craigory1958/SBC6502/README.md

# SBC6502

Single Board Computer for 6502 Processors
