craigory1958/SBC6502/Bus-Timing/SBC6502 MMU Cycle.png

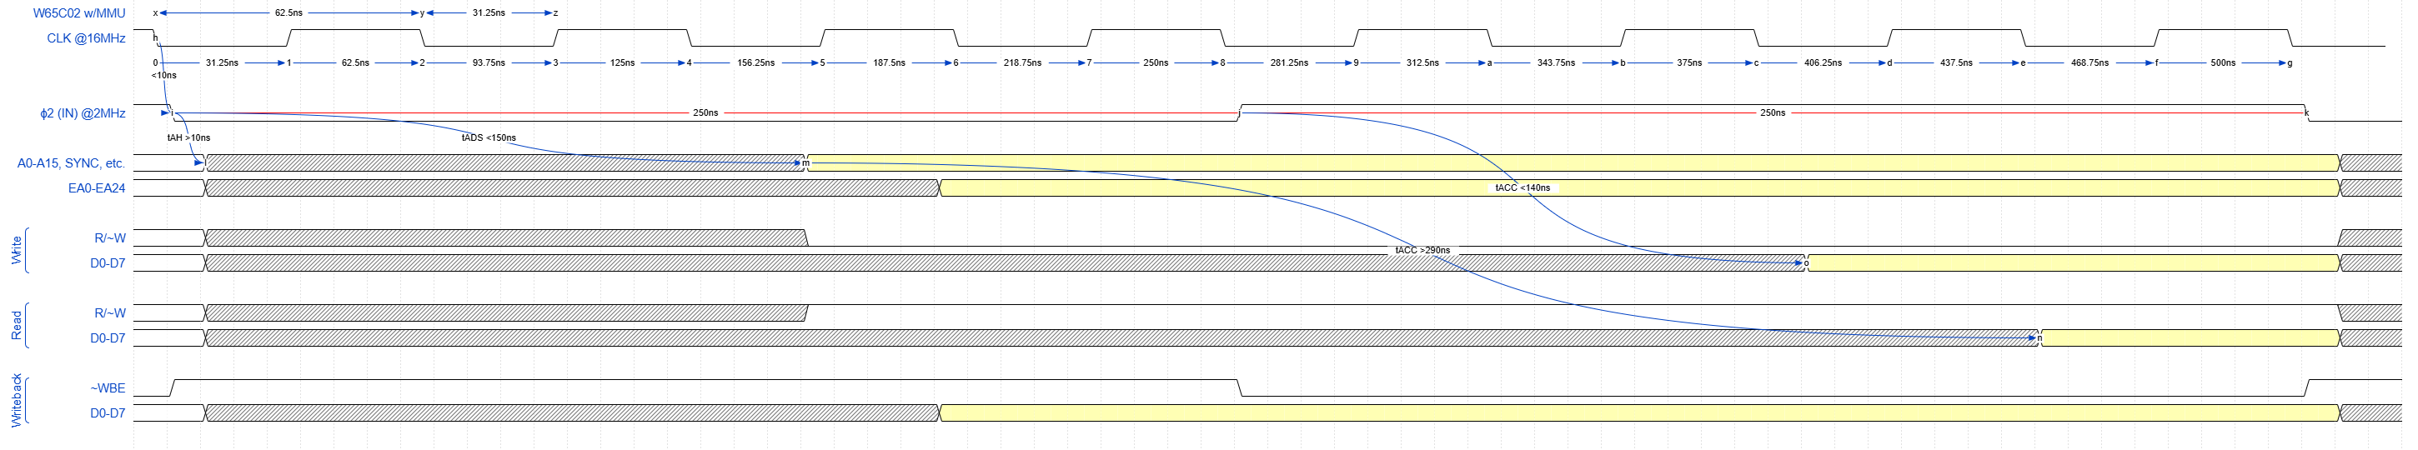
Bus-Timing/SBC6502 MMU Cycle.png
