craigory1958/SBC6502/sc701_v1.0.1_2023-04-07_11-06_schematic.pdf

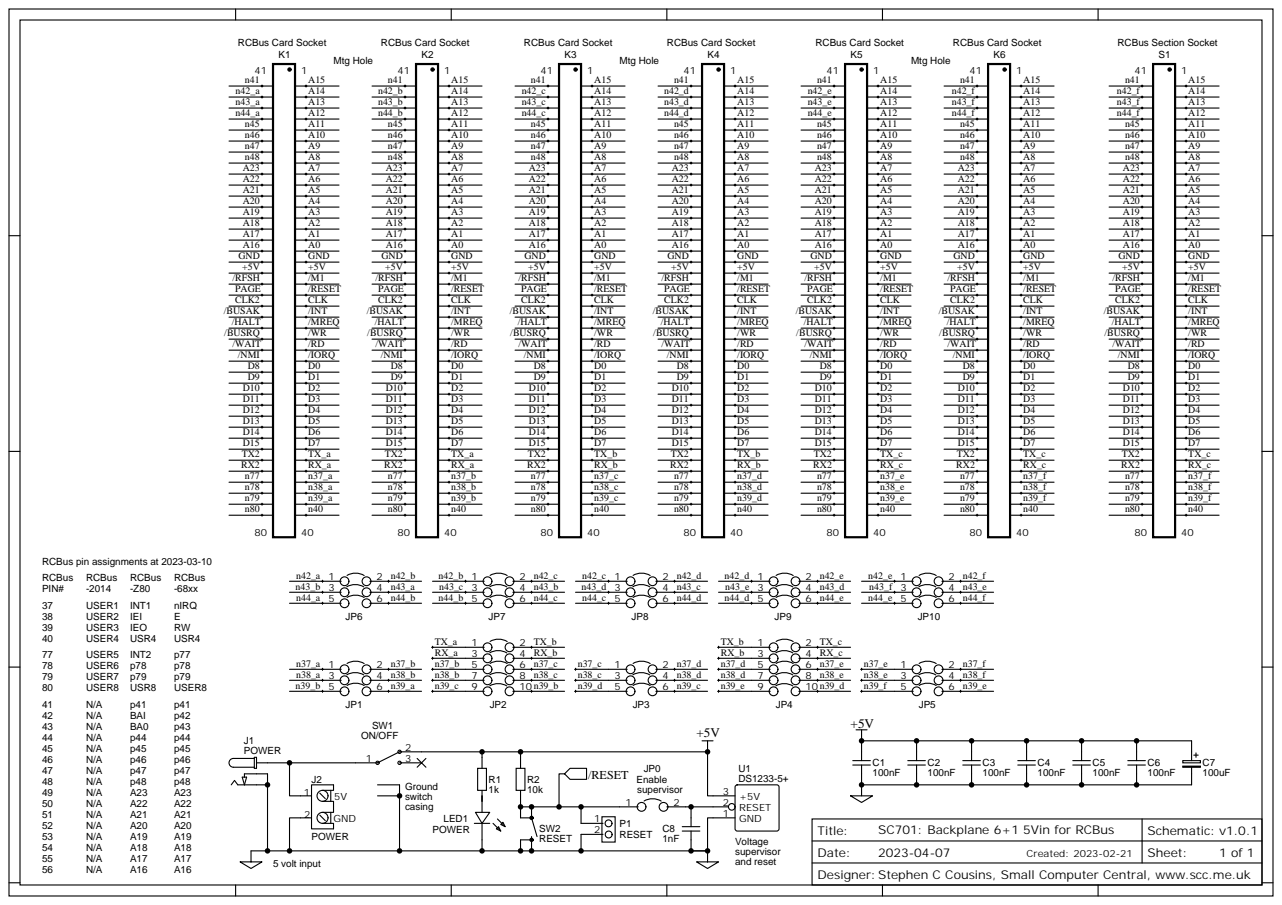
[picture p9: page 1]

Stephen C Cousins, Small Computer Central, www.scc.me.uk
