craigory1958/SBC6502/_pcb_kicad/SBC6502/SBC6502_CPU.kicad_sch

## KiCad design _pcb_kicad/SBC6502/SBC6502_CPU.kicad_sch (2026-02-22)

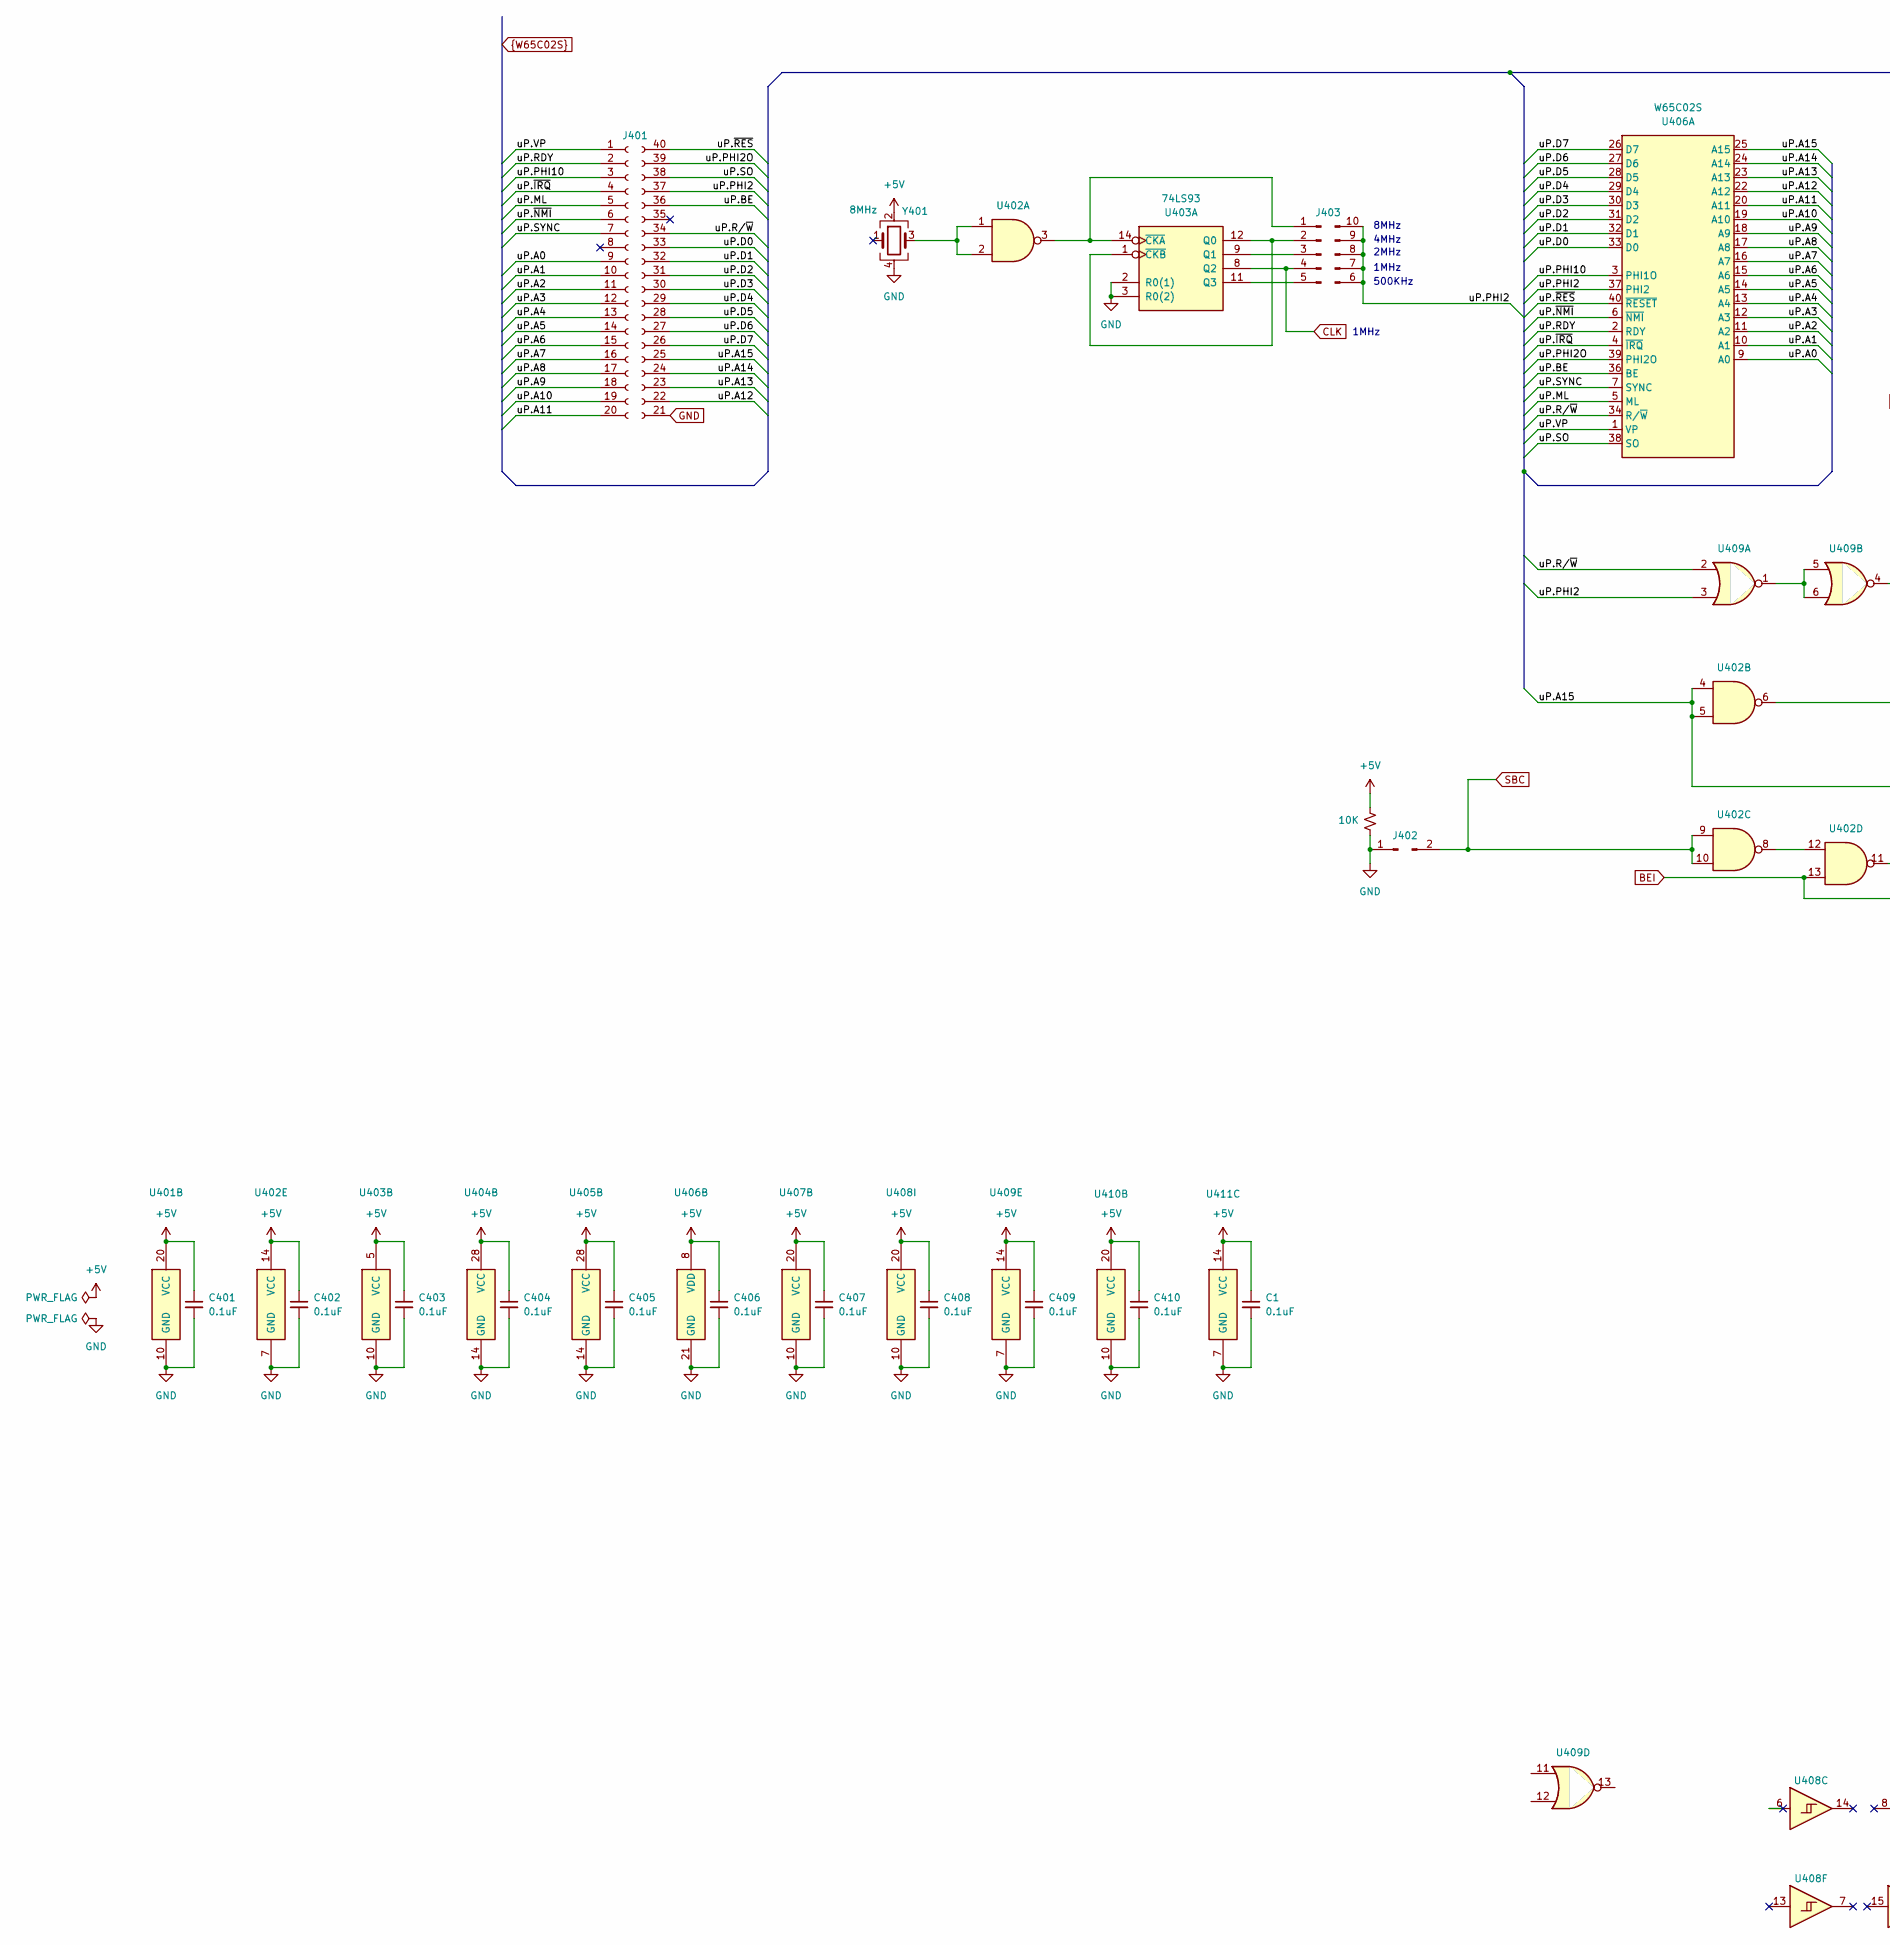
[picture p10: schematic SBC6502_CPU.kicad_sch, part in row 1, column 1]

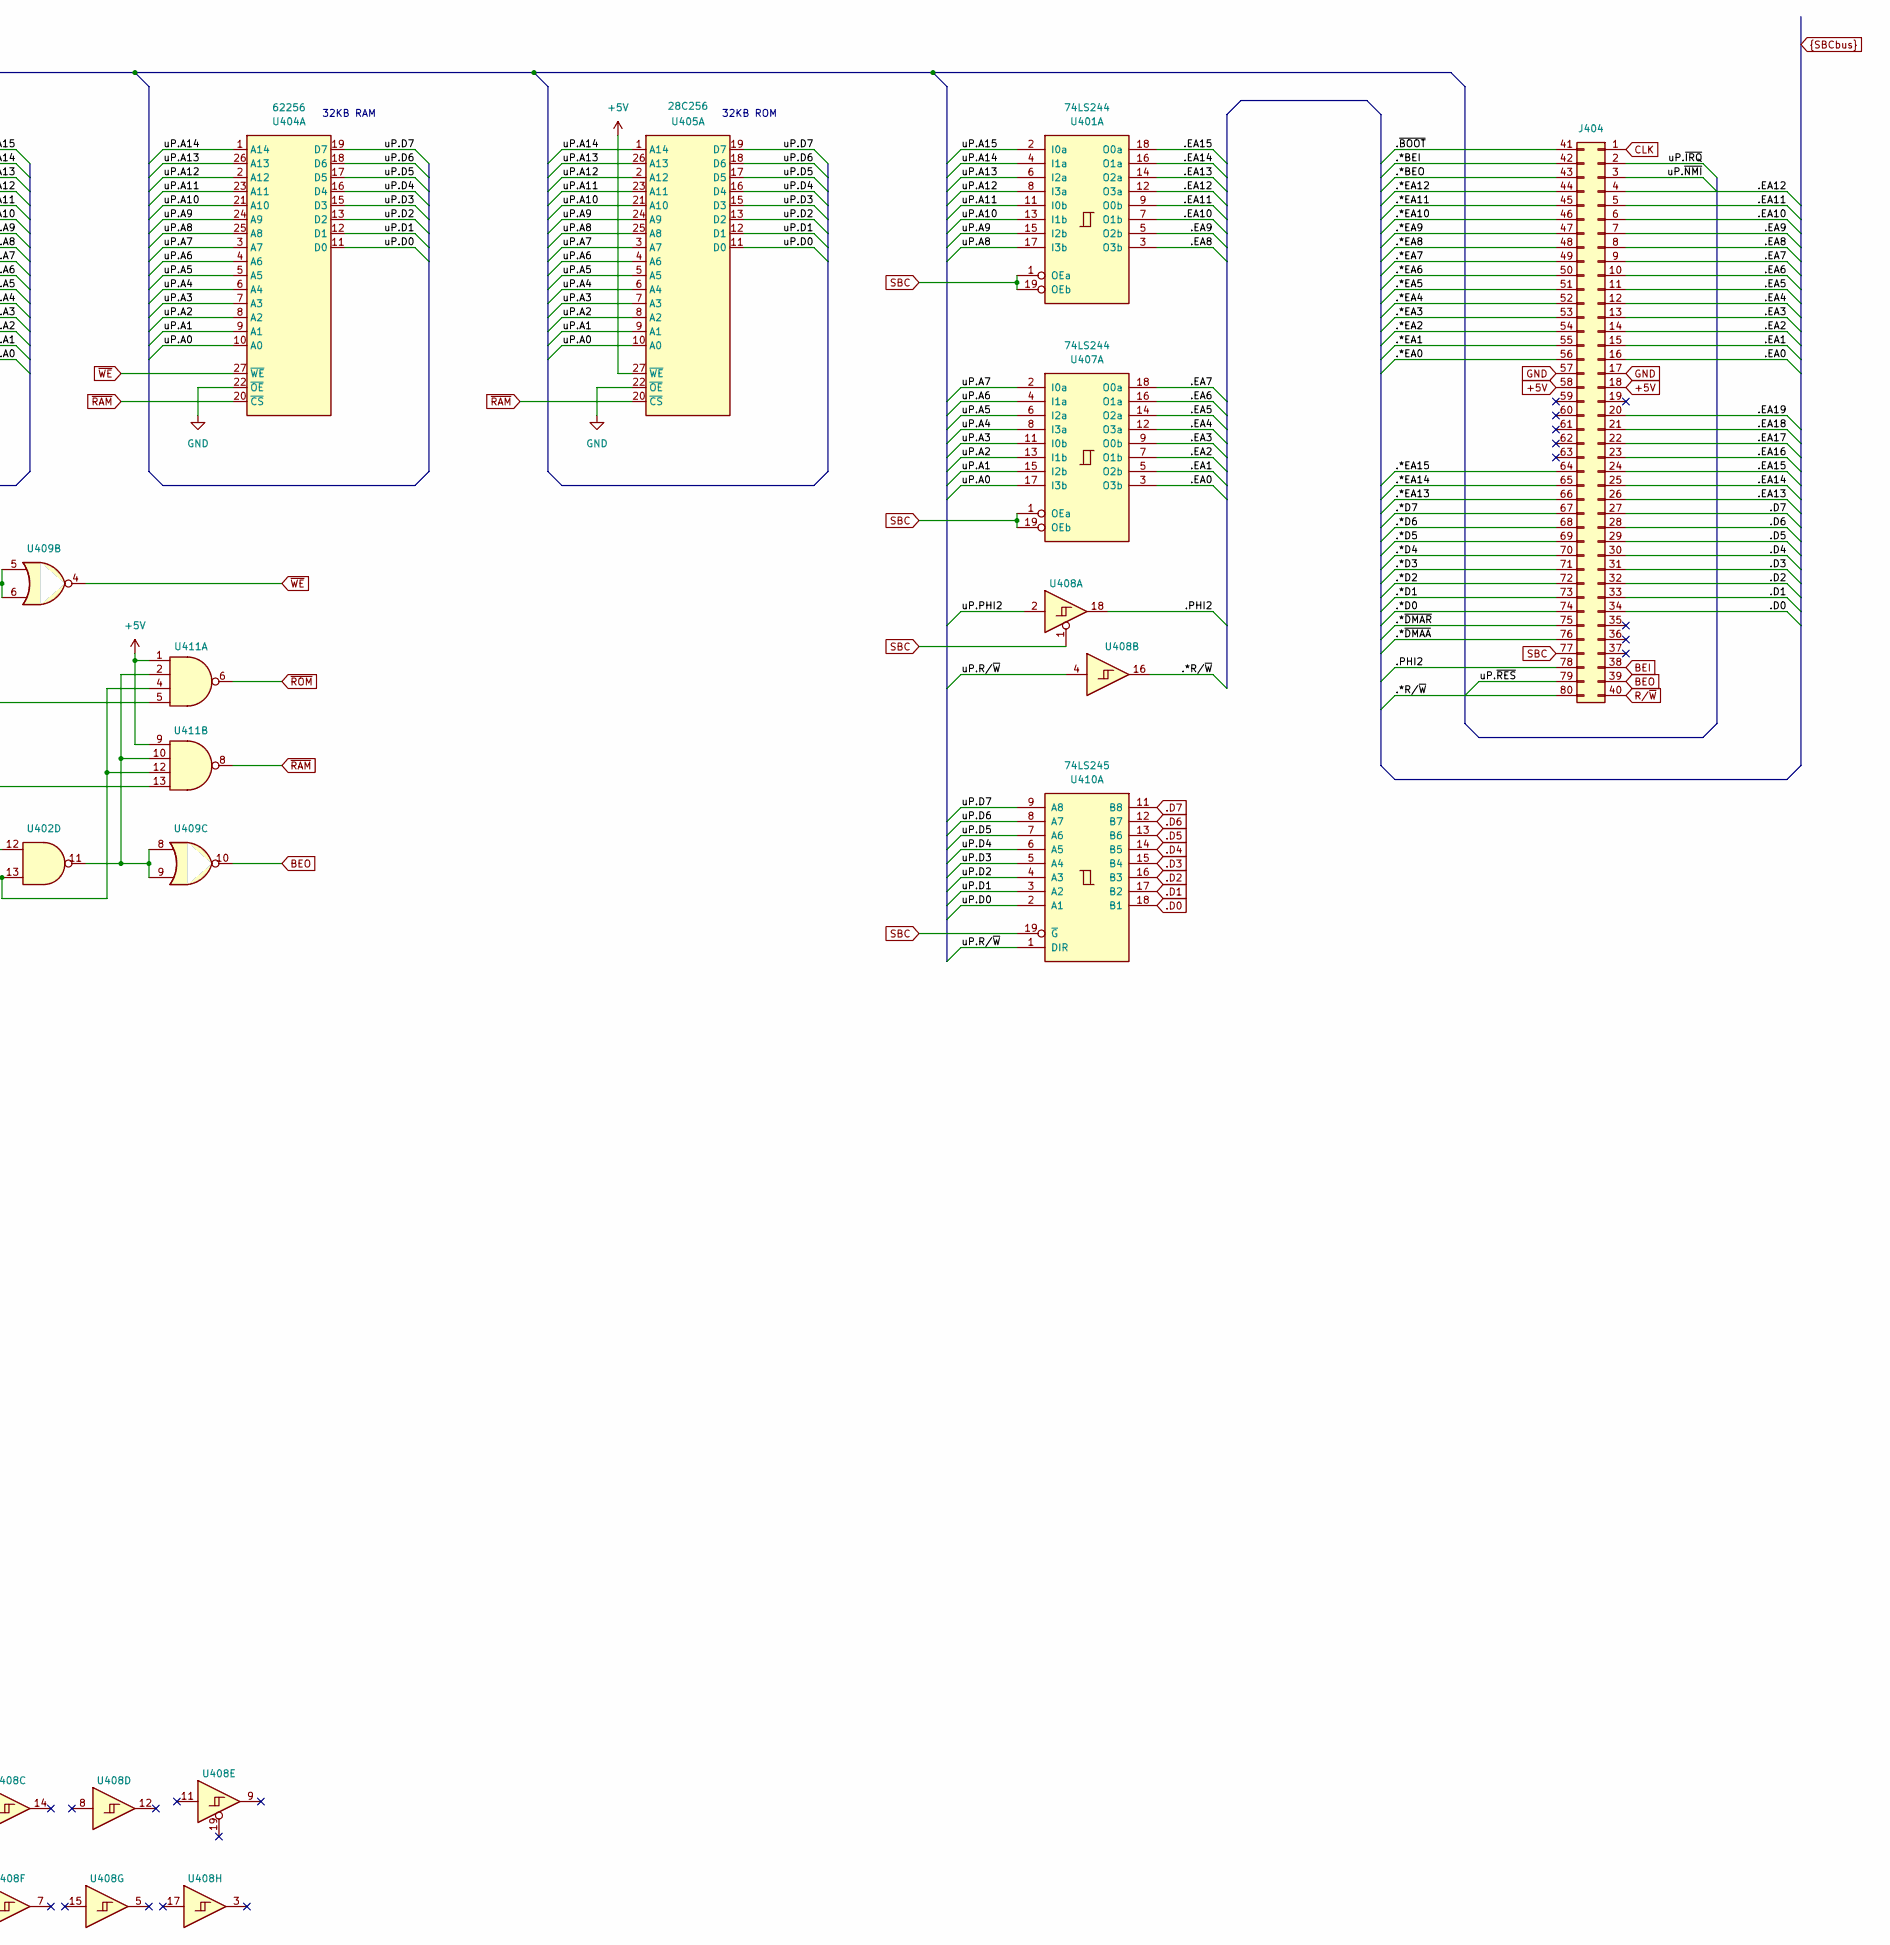
[picture p11: schematic SBC6502_CPU.kicad_sch, part in row 1, column 2]

Parts:
C1, C401, C402, C403, C404, C405, C406, C407, C408, C409, C410: 0.1uF; C_Disc_D3.0mm_W1.6mm_P2.50mm
J401: Conn_02x20_Socket
J402: Conn_02x01_Pin
J403: Conn_02x05_Pin
J404: Conn_02x40_Top_Bottom
R401: 10K
U401, U407, U408: 74LS244; DIP-20_W7.62mm
U402: 74LS00; DIP-14_W7.62mm
U403: 74LS93; DIP-16_W7.62mm
U404: 62256; DIP-28_W15.24mm
U405: 28C256; DIP-28_W15.24mm
U406: W65C02S; DIP-40_W15.24mm
U409: 74LS02; DIP-14_W7.62mm
U410: 74LS245; DIP-20_W7.62mm
U411: 74LS20; DIP-14_W7.62mm
Y401: 8MHz

Connections:
+5V: C1.1, C401.1, C402.1, C403.1, C404.1, C405.1, C406.1, C407.1, C408.1, C409.1, C410.1, J404.18, J404.58, R401.1, U401.20 (VCC), U402.14 (VCC), U403.5 (VCC), U404.28 (VCC), U405.27 (~WE), U405.28 (VCC), U406.8 (VDD), U407.20 (VCC), U408.20 (VCC), U409.14 (VCC), U410.20 (VCC), U411.1, U411.9, U411.14 (VCC), Y401.2
.*BEI: J404.42
.*BEO: J404.43
.*D0: J404.74
.*D1: J404.73
.*D2: J404.72
.*D3: J404.71
.*D4: J404.70
.*D5: J404.69
.*D6: J404.68
.*D7: J404.67
.*EA0: J404.56
.*EA1: J404.55
.*EA2: J404.54
.*EA3: J404.53
.*EA4: J404.52
.*EA5: J404.51
.*EA6: J404.50
.*EA7: J404.49
.*EA8: J404.48
.*EA9: J404.47
.*EA10: J404.46
.*EA11: J404.45
.*EA12: J404.44
.*EA13: J404.66
.*EA14: J404.65
.*EA15: J404.64
.*R/~W: J404.80, U408.16
.*~DMAA: J404.76
.*~DMAR: J404.75
.D0: J404.34, U410.18 (B1)
.D1: J404.33, U410.17 (B2)
.D2: J404.32, U410.16 (B3)
.D3: J404.31, U410.15 (B4)
.D4: J404.30, U410.14 (B5)
.D5: J404.29, U410.13 (B6)
.D6: J404.28, U410.12 (B7)
.D7: J404.27, U410.11 (B8)
.EA0: J404.16, U407.3 (O3b)
.EA1: J404.15, U407.5 (O2b)
.EA2: J404.14, U407.7 (O1b)
.EA3: J404.13, U407.9 (O0b)
.EA4: J404.12, U407.12 (O3a)
.EA5: J404.11, U407.14 (O2a)
.EA6: J404.10, U407.16 (O1a)
.EA7: J404.9, U407.18 (O0a)
.EA8: J404.8, U401.3 (O3b)
.EA9: J404.7, U401.5 (O2b)
.EA10: J404.6, U401.7 (O1b)
.EA11: J404.5, U401.9 (O0b)
.EA12: J404.4, U401.12 (O3a)
.EA13: J404.26, U401.14 (O2a)
.EA14: J404.25, U401.16 (O1a)
.EA15: J404.24, U401.18 (O0a)
.EA16: J404.23
.EA17: J404.22
.EA18: J404.21
.EA19: J404.20
.PHI2: J404.78, U408.18
.~BOOT: J404.41
BEI: J404.38, U402.13, U411.4, U411.12
BEO: J404.39, U409.10
CLK: J403.4, J404.1, U403.8 (Q2)
GND: C1.2, C401.2, C402.2, C403.2, C404.2, C405.2, C406.2, C407.2, C408.2, C409.2, C410.2, J401.21, J402.1, J404.17, J404.57, R401.2, U401.10 (GND), U402.7 (GND), U403.2 (R0(1)), U403.3 (R0(2)), U403.10 (GND), U404.14 (GND), U404.22 (~OE), U405.14 (GND), U405.22 (~OE), U406.21 (GND), U407.10 (GND), U408.10 (GND), U409.7 (GND), U410.10 (GND), U411.7 (GND), Y401.4
unnamed: J403.1, U402.3, U403.14 (~CKA)
unnamed: J403.2, U403.1 (~CKB), U403.12 (Q0)
unnamed: J403.3, U403.9 (Q1)
unnamed: J403.5, U403.11 (Q3)
unnamed: U402.1, U402.2, Y401.3
unnamed: U402.6, U411.5
unnamed: U402.11, U409.8, U409.9, U411.2, U411.10
unnamed: U402.8, U402.12
unnamed: U409.1, U409.5, U409.6
R/~W: J404.40
SBC: J402.2, J404.77, U401.1 (OEa), U401.19 (OEb), U402.9, U402.10, U407.1 (OEa), U407.19 (OEb), U408.1, U410.19 (~G)
uP.A0: J401.9, U404.10 (A0), U405.10 (A0), U406.9 (A0), U407.17 (I3b)
uP.A1: J401.10, U404.9 (A1), U405.9 (A1), U406.10 (A1), U407.15 (I2b)
uP.A2: J401.11, U404.8 (A2), U405.8 (A2), U406.11 (A2), U407.13 (I1b)
uP.A3: J401.12, U404.7 (A3), U405.7 (A3), U406.12 (A3), U407.11 (I0b)
uP.A4: J401.13, U404.6 (A4), U405.6 (A4), U406.13 (A4), U407.8 (I3a)
uP.A5: J401.14, U404.5 (A5), U405.5 (A5), U406.14 (A5), U407.6 (I2a)
uP.A6: J401.15, U404.4 (A6), U405.4 (A6), U406.15 (A6), U407.4 (I1a)
uP.A7: J401.16, U404.3 (A7), U405.3 (A7), U406.16 (A7), U407.2 (I0a)
uP.A8: J401.17, U401.17 (I3b), U404.25 (A8), U405.25 (A8), U406.17 (A8)
uP.A9: J401.18, U401.15 (I2b), U404.24 (A9), U405.24 (A9), U406.18 (A9)
uP.A10: J401.19, U401.13 (I1b), U404.21 (A10), U405.21 (A10), U406.19 (A10)
uP.A11: J401.20, U401.11 (I0b), U404.23 (A11), U405.23 (A11), U406.20 (A11)
uP.A12: J401.22, U401.8 (I3a), U404.2 (A12), U405.2 (A12), U406.22 (A12)
uP.A13: J401.23, U401.6 (I2a), U404.26 (A13), U405.26 (A13), U406.23 (A13)
uP.A14: J401.24, U401.4 (I1a), U404.1 (A14), U405.1 (A14), U406.24 (A14)
uP.A15: J401.25, U401.2 (I0a), U402.4, U402.5, U406.25 (A15), U411.13
uP.BE: J401.36, U406.36 (BE)
uP.D0: J401.33, U404.11 (D0), U405.11 (D0), U406.33 (D0), U410.2 (A1)
uP.D1: J401.32, U404.12 (D1), U405.12 (D1), U406.32 (D1), U410.3 (A2)
uP.D2: J401.31, U404.13 (D2), U405.13 (D2), U406.31 (D2), U410.4 (A3)
uP.D3: J401.30, U404.15 (D3), U405.15 (D3), U406.30 (D3), U410.5 (A4)
uP.D4: J401.29, U404.16 (D4), U405.16 (D4), U406.29 (D4), U410.6 (A5)
uP.D5: J401.28, U404.17 (D5), U405.17 (D5), U406.28 (D5), U410.7 (A6)
uP.D6: J401.27, U404.18 (D6), U405.18 (D6), U406.27 (D6), U410.8 (A7)
uP.D7: J401.26, U404.19 (D7), U405.19 (D7), U406.26 (D7), U410.9 (A8)
uP.ML: J401.5, U406.5 (ML)
uP.PHI2: J401.37, J403.6, J403.7, J403.8, J403.9, J403.10, U406.37 (PHI2), U408.2, U409.3
uP.PHI2O: J401.39, U406.39 (PHI2O)
uP.PHI10: J401.3, U406.3 (PHI1O)
uP.RDY: J401.2, U406.2 (RDY)
uP.R/~W: J401.34, U406.34 (R/~W), U408.4, U409.2, U410.1 (DIR)
uP.SO: J401.38, U406.38 (SO)
uP.SYNC: J401.7, U406.7 (SYNC)
uP.VP: J401.1, U406.1 (VP)
uP.~IRQ: J401.4, J404.2, U406.4 (~IRQ)
uP.~NMI: J401.6, J404.3, U406.6 (~NMI)
uP.~RES: J401.40, J404.79, U406.40 (~RESET)
~RAM: U404.20 (~CS), U405.20 (~CS), U411.8
~ROM: U411.6
~WE: U404.27 (~WE), U409.4

Notes on the sheet:
32KB RAM
8MHz
500KHz
1MHz
4MHz
32KB ROM
2MHz
