craigory1958/SBC6502/_pcb_kicad/SBC6502/SBC6502_Memory.kicad_sch

## KiCad design _pcb_kicad/SBC6502/SBC6502_Memory.kicad_sch (2026-02-22)

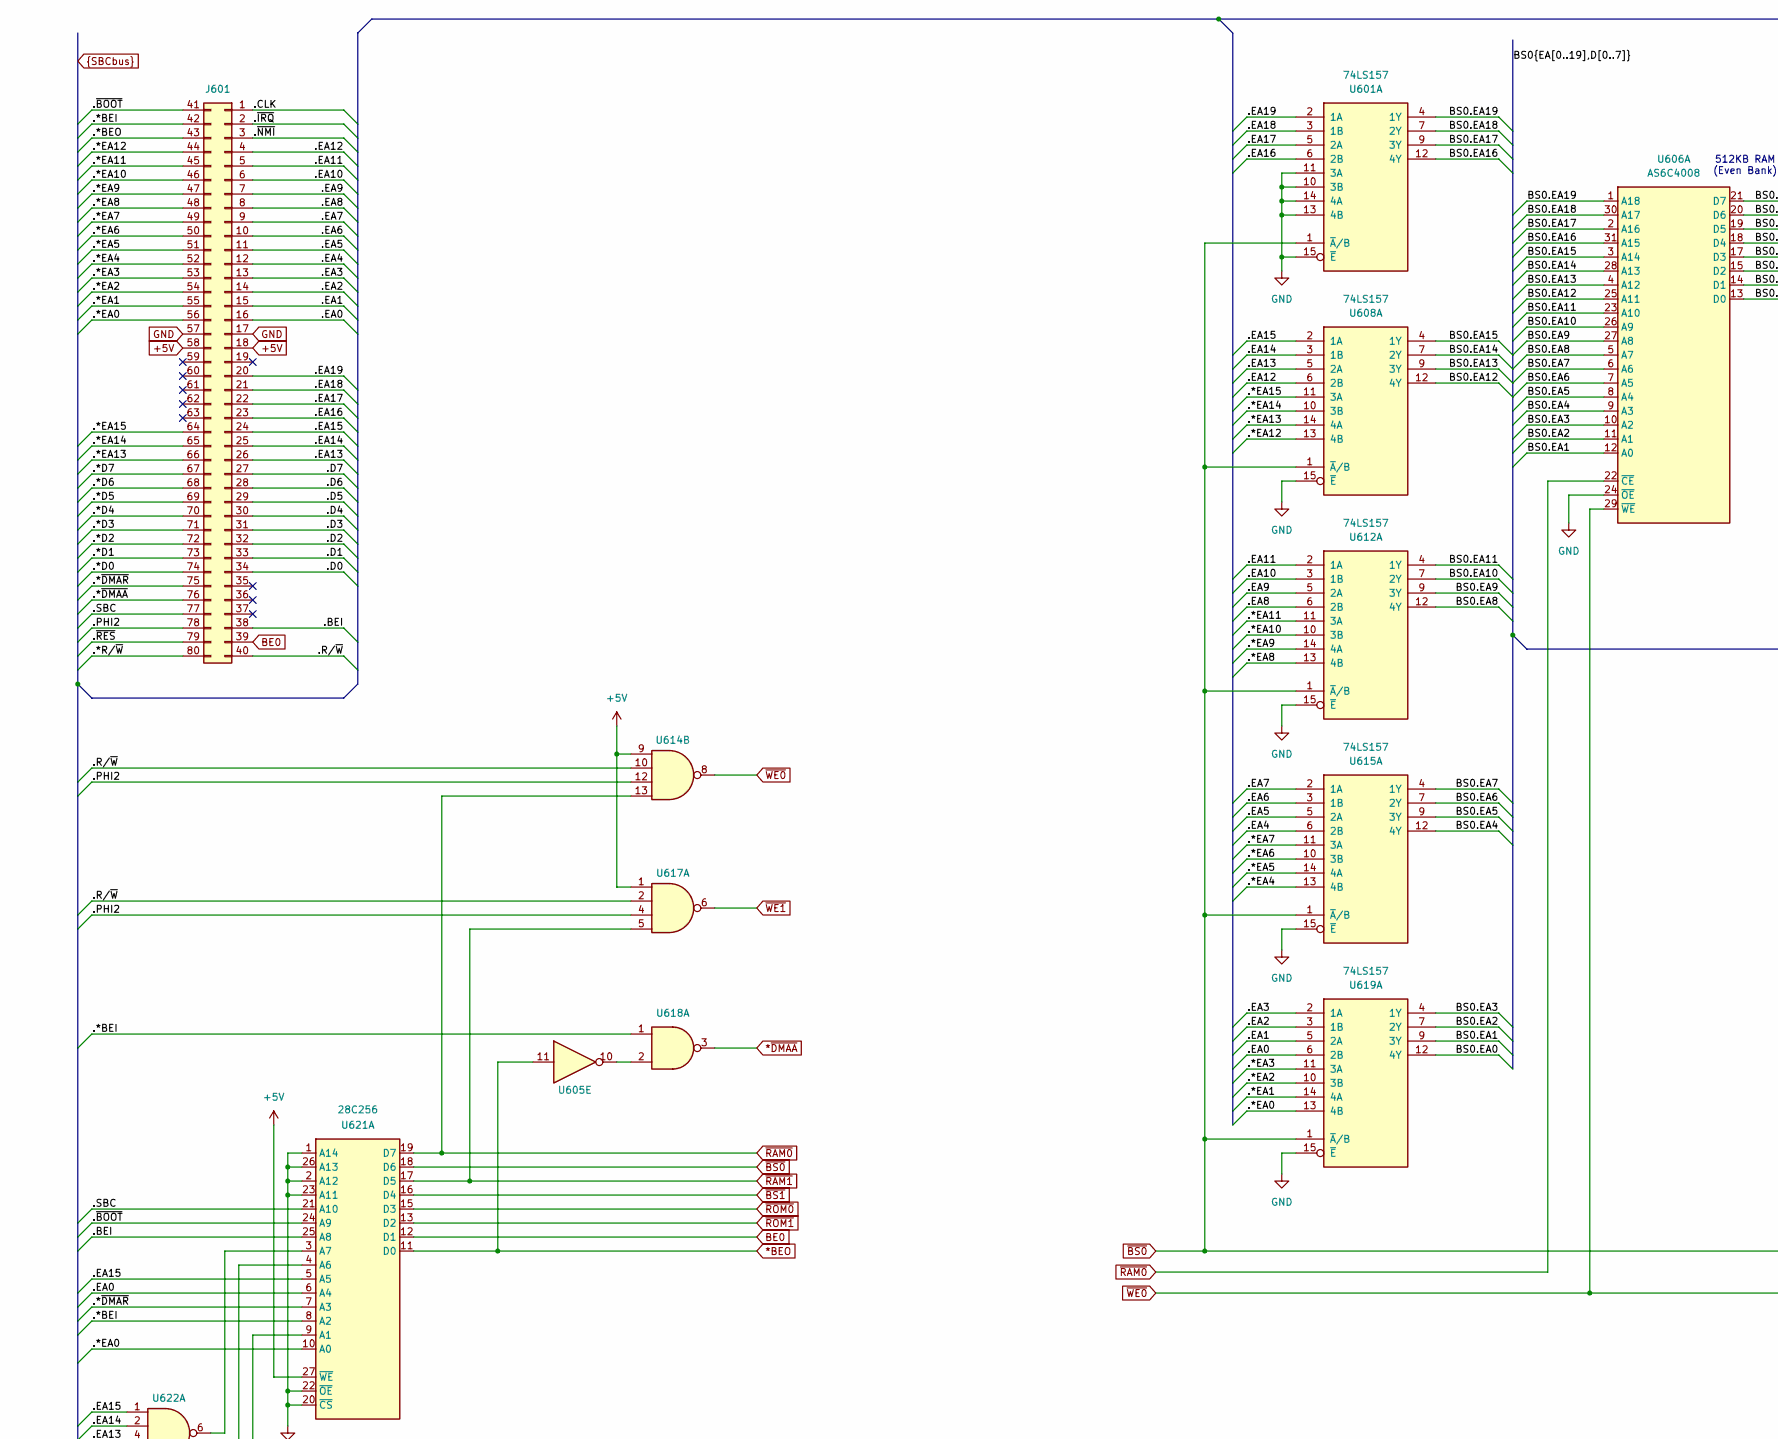
[picture p12: schematic SBC6502_Memory.kicad_sch, part in row 1, column 1]

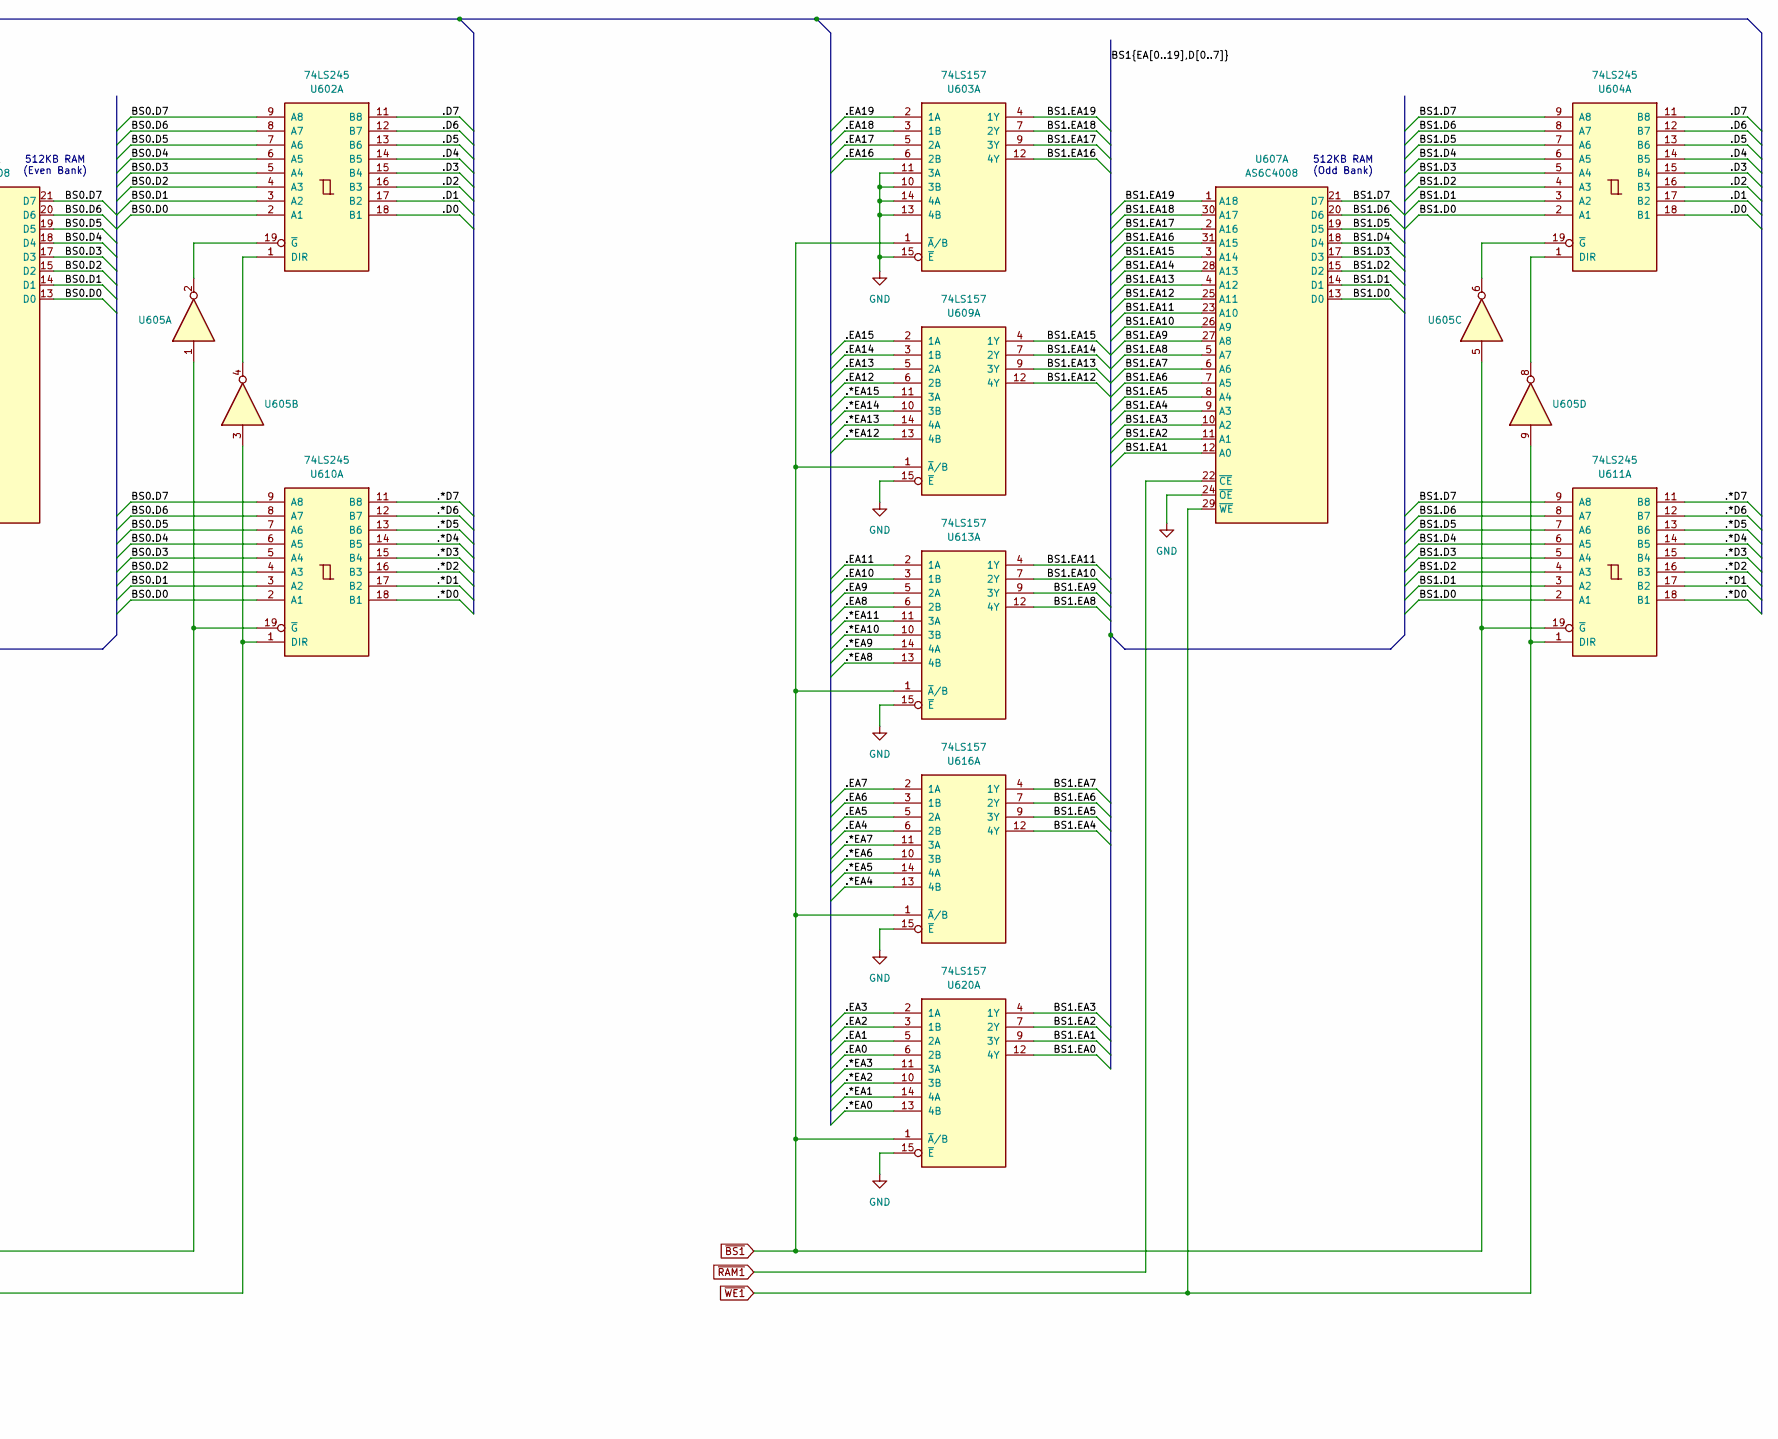
[picture p13: schematic SBC6502_Memory.kicad_sch, part in row 1, column 2]

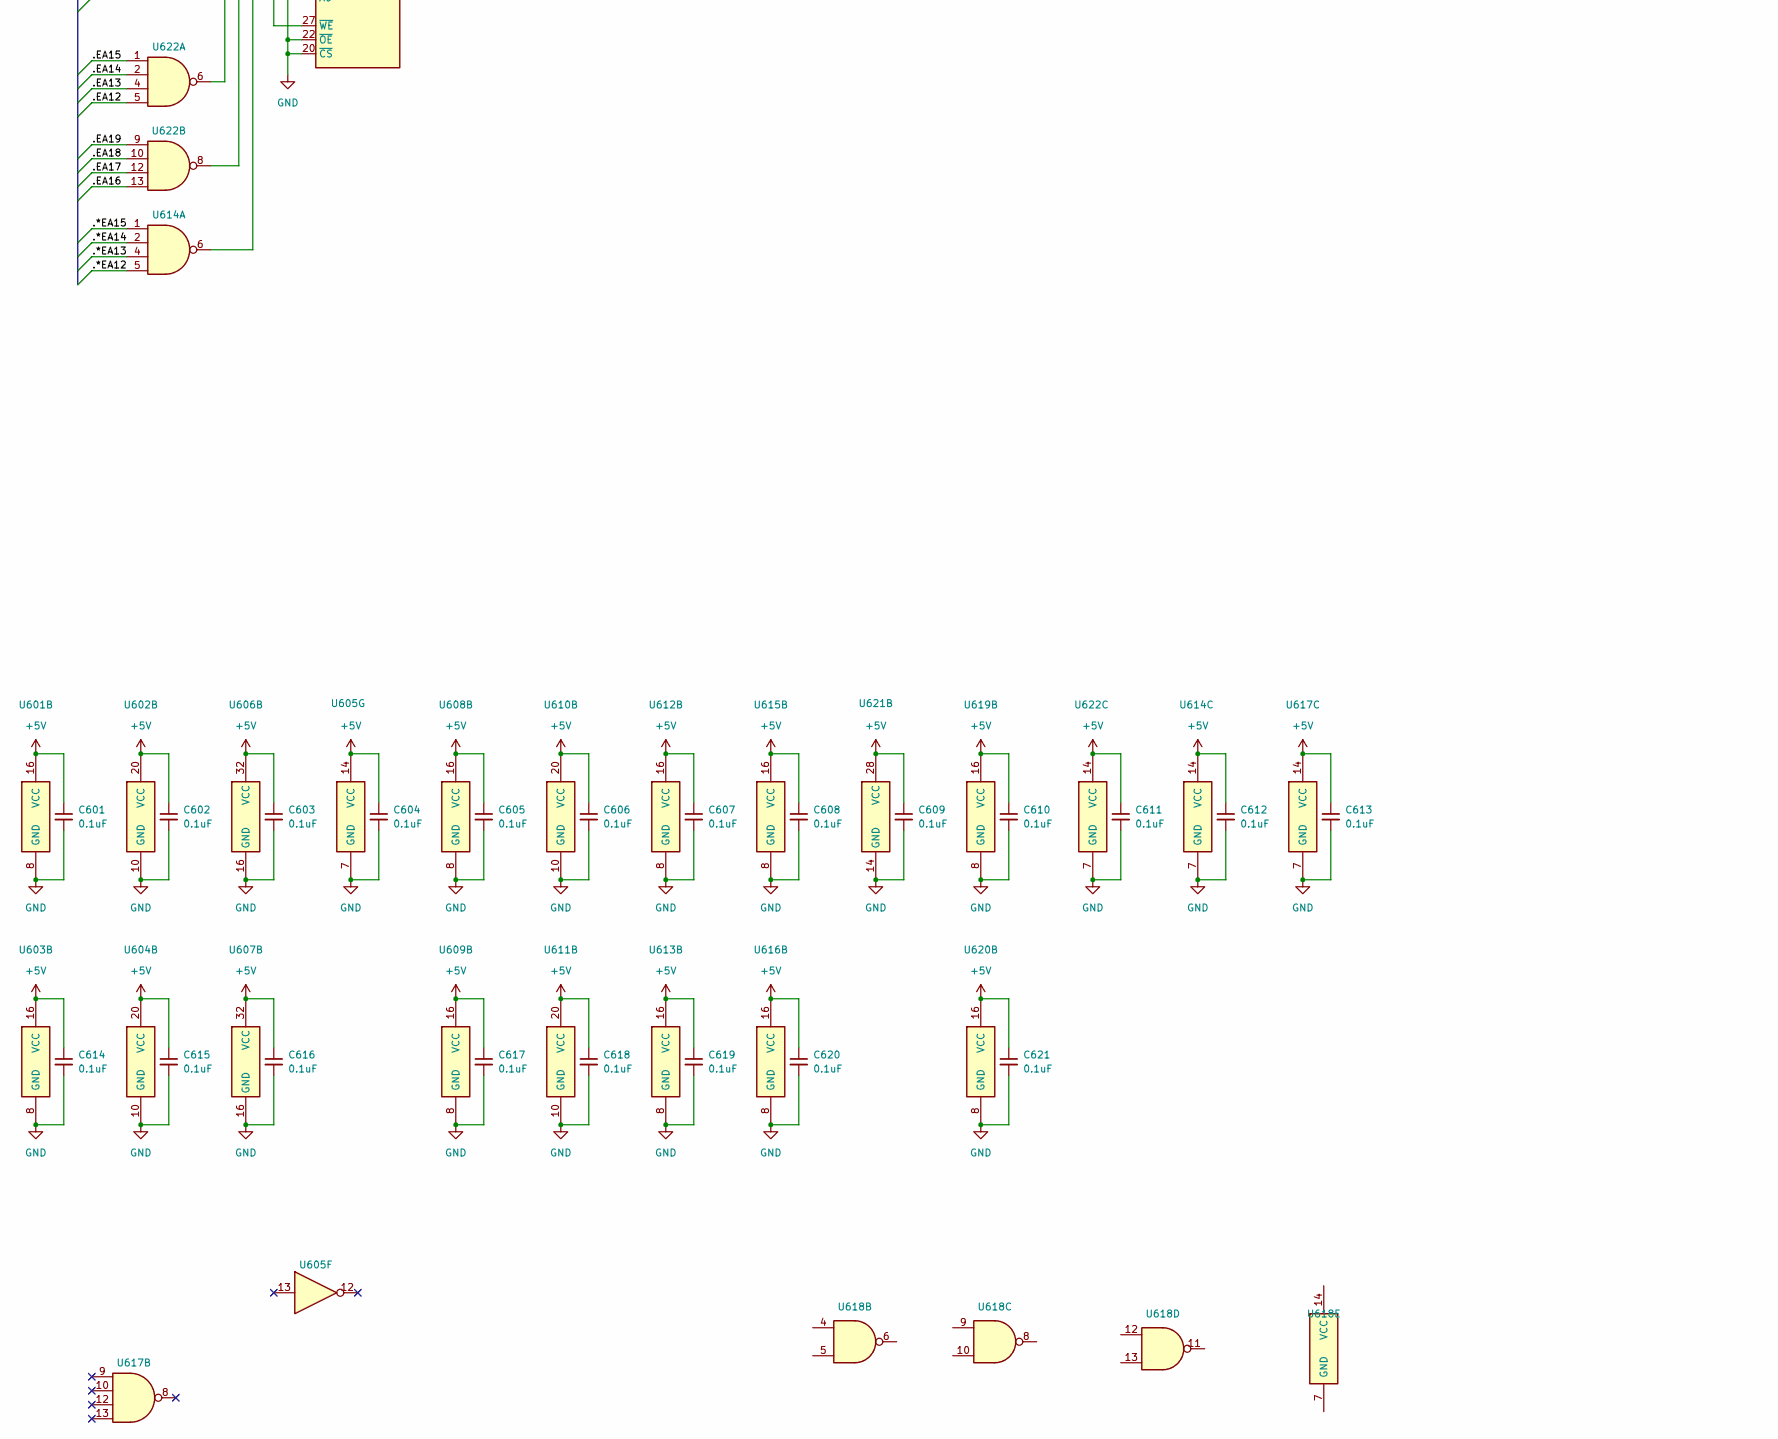
[picture p14: schematic SBC6502_Memory.kicad_sch, part in row 2, column 1]

Parts:
C601, C602, C603, C604, C605, C606, C607, C608, C609, C610, C611, C612, C613, C614, C615, C616, C617, C618, C619, C620, C621: 0.1uF; C_Disc_D3.0mm_W1.6mm_P2.50mm
J601: Conn_02x40_Top_Bottom
U601, U603, U608, U609, U612, U613, U615, U616, U619, U620: 74LS157; DIP-16_W7.62mm
U602, U604, U610, U611: 74LS245; DIP-20_W7.62mm
U605: 74LS06; DIP-14_W7.62mm
U606, U607: AS6C4008; DIP-32_W15.24mm
U614, U617, U622: 74LS20; DIP-14_W7.62mm
U618: 74LS00; DIP-14_W7.62mm
U621: 28C256; DIP-28_W15.24mm

Connections:
+5V: C601.1, C602.1, C603.1, C604.1, C605.1, C606.1, C607.1, C608.1, C609.1, C610.1, C611.1, C612.1, C613.1, C614.1, C615.1, C616.1, C617.1, C618.1, C619.1, C620.1, C621.1, J601.18, J601.58, U601.16 (VCC), U602.20 (VCC), U603.16 (VCC), U604.20 (VCC), U605.14 (VCC), U606.32 (VCC), U607.32 (VCC), U608.16 (VCC), U609.16 (VCC), U610.20 (VCC), U611.20 (VCC), U612.16 (VCC), U613.16 (VCC), U614.9, U614.14 (VCC), U615.16 (VCC), U616.16 (VCC), U617.1, U617.14 (VCC), U619.16 (VCC), U620.16 (VCC), U621.27 (~WE), U621.28 (VCC), U622.14 (VCC)
.*BEI: J601.42, U618.1, U621.8 (A2)
.*BEO: J601.43
.*D0: J601.74, U610.18 (B1), U611.18 (B1)
.*D1: J601.73, U610.17 (B2), U611.17 (B2)
.*D2: J601.72, U610.16 (B3), U611.16 (B3)
.*D3: J601.71, U610.15 (B4), U611.15 (B4)
.*D4: J601.70, U610.14 (B5), U611.14 (B5)
.*D5: J601.69, U610.13 (B6), U611.13 (B6)
.*D6: J601.68, U610.12 (B7), U611.12 (B7)
.*D7: J601.67, U610.11 (B8), U611.11 (B8)
.*EA0: J601.56, U619.13 (4B), U620.13 (4B), U621.10 (A0)
.*EA1: J601.55, U619.14 (4A), U620.14 (4A)
.*EA2: J601.54, U619.10 (3B), U620.10 (3B)
.*EA3: J601.53, U619.11 (3A), U620.11 (3A)
.*EA4: J601.52, U615.13 (4B), U616.13 (4B)
.*EA5: J601.51, U615.14 (4A), U616.14 (4A)
.*EA6: J601.50, U615.10 (3B), U616.10 (3B)
.*EA7: J601.49, U615.11 (3A), U616.11 (3A)
.*EA8: J601.48, U612.13 (4B), U613.13 (4B)
.*EA9: J601.47, U612.14 (4A), U613.14 (4A)
.*EA10: J601.46, U612.10 (3B), U613.10 (3B)
.*EA11: J601.45, U612.11 (3A), U613.11 (3A)
.*EA12: J601.44, U608.13 (4B), U609.13 (4B), U614.5
.*EA13: J601.66, U608.14 (4A), U609.14 (4A), U614.4
.*EA14: J601.65, U608.10 (3B), U609.10 (3B), U614.2
.*EA15: J601.64, U608.11 (3A), U609.11 (3A), U614.1
.*R/~W: J601.80
.*~DMAA: J601.76
.*~DMAR: J601.75, U621.7 (A3)
.BEI: J601.38, U621.25 (A8)
.CLK: J601.1
.D0: J601.34, U602.18 (B1), U604.18 (B1)
.D1: J601.33, U602.17 (B2), U604.17 (B2)
.D2: J601.32, U602.16 (B3), U604.16 (B3)
.D3: J601.31, U602.15 (B4), U604.15 (B4)
.D4: J601.30, U602.14 (B5), U604.14 (B5)
.D5: J601.29, U602.13 (B6), U604.13 (B6)
.D6: J601.28, U602.12 (B7), U604.12 (B7)
.D7: J601.27, U602.11 (B8), U604.11 (B8)
.EA0: J601.16, U619.6 (2B), U620.6 (2B), U621.6 (A4)
.EA1: J601.15, U619.5 (2A), U620.5 (2A)
.EA2: J601.14, U619.3 (1B), U620.3 (1B)
.EA3: J601.13, U619.2 (1A), U620.2 (1A)
.EA4: J601.12, U615.6 (2B), U616.6 (2B)
.EA5: J601.11, U615.5 (2A), U616.5 (2A)
.EA6: J601.10, U615.3 (1B), U616.3 (1B)
.EA7: J601.9, U615.2 (1A), U616.2 (1A)
.EA8: J601.8, U612.6 (2B), U613.6 (2B)
.EA9: J601.7, U612.5 (2A), U613.5 (2A)
.EA10: J601.6, U612.3 (1B), U613.3 (1B)
.EA11: J601.5, U612.2 (1A), U613.2 (1A)
.EA12: J601.4, U608.6 (2B), U609.6 (2B), U622.5
.EA13: J601.26, U608.5 (2A), U609.5 (2A), U622.4
.EA14: J601.25, U608.3 (1B), U609.3 (1B), U622.2
.EA15: J601.24, U608.2 (1A), U609.2 (1A), U621.5 (A5), U622.1
.EA16: J601.23, U601.6 (2B), U603.6 (2B), U622.13
.EA17: J601.22, U601.5 (2A), U603.5 (2A), U622.12
.EA18: J601.21, U601.3 (1B), U603.3 (1B), U622.10
.EA19: J601.20, U601.2 (1A), U603.2 (1A), U622.9
.PHI2: J601.78, U614.12, U617.4
.R/~W: J601.40, U614.10, U617.2
.SBC: J601.77, U621.21 (A10)
.~BOOT: J601.41, U621.24 (A9)
.~IRQ: J601.2
.~NMI: J601.3
.~RES: J601.79
BE0: J601.39, U621.12 (D1)
BS0.D0: U602.2 (A1), U606.13 (D0), U610.2 (A1)
BS0.D1: U602.3 (A2), U606.14 (D1), U610.3 (A2)
BS0.D2: U602.4 (A3), U606.15 (D2), U610.4 (A3)
BS0.D3: U602.5 (A4), U606.17 (D3), U610.5 (A4)
BS0.D4: U602.6 (A5), U606.18 (D4), U610.6 (A5)
BS0.D5: U602.7 (A6), U606.19 (D5), U610.7 (A6)
BS0.D6: U602.8 (A7), U606.20 (D6), U610.8 (A7)
BS0.D7: U602.9 (A8), U606.21 (D7), U610.9 (A8)
BS0.EA0: U619.12 (4Y)
BS0.EA1: U606.12 (A0), U619.9 (3Y)
BS0.EA2: U606.11 (A1), U619.7 (2Y)
BS0.EA3: U606.10 (A2), U619.4 (1Y)
BS0.EA4: U606.9 (A3), U615.12 (4Y)
BS0.EA5: U606.8 (A4), U615.9 (3Y)
BS0.EA6: U606.7 (A5), U615.7 (2Y)
BS0.EA7: U606.6 (A6), U615.4 (1Y)
BS0.EA8: U606.5 (A7), U612.12 (4Y)
BS0.EA9: U606.27 (A8), U612.9 (3Y)
BS0.EA10: U606.26 (A9), U612.7 (2Y)
BS0.EA11: U606.23 (A10), U612.4 (1Y)
BS0.EA12: U606.25 (A11), U608.12 (4Y)
BS0.EA13: U606.4 (A12), U608.9 (3Y)
BS0.EA14: U606.28 (A13), U608.7 (2Y)
BS0.EA15: U606.3 (A14), U608.4 (1Y)
BS0.EA16: U601.12 (4Y), U606.31 (A15)
BS0.EA17: U601.9 (3Y), U606.2 (A16)
BS0.EA18: U601.7 (2Y), U606.30 (A17)
BS0.EA19: U601.4 (1Y), U606.1 (A18)
BS1.D0: U604.2 (A1), U607.13 (D0), U611.2 (A1)
BS1.D1: U604.3 (A2), U607.14 (D1), U611.3 (A2)
BS1.D2: U604.4 (A3), U607.15 (D2), U611.4 (A3)
BS1.D3: U604.5 (A4), U607.17 (D3), U611.5 (A4)
BS1.D4: U604.6 (A5), U607.18 (D4), U611.6 (A5)
BS1.D5: U604.7 (A6), U607.19 (D5), U611.7 (A6)
BS1.D6: U604.8 (A7), U607.20 (D6), U611.8 (A7)
BS1.D7: U604.9 (A8), U607.21 (D7), U611.9 (A8)
BS1.EA0: U620.12 (4Y)
BS1.EA1: U607.12 (A0), U620.9 (3Y)
BS1.EA2: U607.11 (A1), U620.7 (2Y)
BS1.EA3: U607.10 (A2), U620.4 (1Y)
BS1.EA4: U607.9 (A3), U616.12 (4Y)
BS1.EA5: U607.8 (A4), U616.9 (3Y)
BS1.EA6: U607.7 (A5), U616.7 (2Y)
BS1.EA7: U607.6 (A6), U616.4 (1Y)
BS1.EA8: U607.5 (A7), U613.12 (4Y)
BS1.EA9: U607.27 (A8), U613.9 (3Y)
BS1.EA10: U607.26 (A9), U613.7 (2Y)
BS1.EA11: U607.23 (A10), U613.4 (1Y)
BS1.EA12: U607.25 (A11), U609.12 (4Y)
BS1.EA13: U607.4 (A12), U609.9 (3Y)
BS1.EA14: U607.28 (A13), U609.7 (2Y)
BS1.EA15: U607.3 (A14), U609.4 (1Y)
BS1.EA16: U603.12 (4Y), U607.31 (A15)
BS1.EA17: U603.9 (3Y), U607.2 (A16)
BS1.EA18: U603.7 (2Y), U607.30 (A17)
BS1.EA19: U603.4 (1Y), U607.1 (A18)
GND: C601.2, C602.2, C603.2, C604.2, C605.2, C606.2, C607.2, C608.2, C609.2, C610.2, C611.2, C612.2, C613.2, C614.2, C615.2, C616.2, C617.2, C618.2, C619.2, C620.2, C621.2, J601.17, J601.57, U601.8 (GND), U601.10 (3B), U601.11 (3A), U601.13 (4B), U601.14 (4A), U601.15 (~E), U602.10 (GND), U603.8 (GND), U603.10 (3B), U603.11 (3A), U603.13 (4B), U603.14 (4A), U603.15 (~E), U604.10 (GND), U605.7 (GND), U606.16 (GND), U606.24 (~OE), U607.16 (GND), U607.24 (~OE), U608.8 (GND), U608.15 (~E), U609.8 (GND), U609.15 (~E), U610.10 (GND), U611.10 (GND), U612.8 (GND), U612.15 (~E), U613.8 (GND), U613.15 (~E), U614.7 (GND), U615.8 (GND), U615.15 (~E), U616.8 (GND), U616.15 (~E), U617.7 (GND), U619.8 (GND), U619.15 (~E), U620.8 (GND), U620.15 (~E), U621.1 (A14), U621.2 (A12), U621.14 (GND), U621.20 (~CS), U621.22 (~OE), U621.23 (A11), U621.26 (A13), U622.7 (GND)
unnamed: U602.1 (DIR), U605.4
unnamed: U602.19 (~G), U605.2
unnamed: U604.1 (DIR), U605.8
unnamed: U604.19 (~G), U605.6
unnamed: U605.10, U618.2
unnamed: U614.6, U621.9 (A1)
unnamed: U621.3 (A7), U622.6
unnamed: U621.4 (A6), U622.8
beo: U605.11, U621.11 (D0)
~BS0: U601.1 (~A/B), U605.1, U608.1 (~A/B), U610.19 (~G), U612.1 (~A/B), U615.1 (~A/B), U619.1 (~A/B), U621.18 (D6)
~BS1: U603.1 (~A/B), U605.5, U609.1 (~A/B), U611.19 (~G), U613.1 (~A/B), U616.1 (~A/B), U620.1 (~A/B), U621.16 (D4)
~RAM0: U606.22 (~CE), U614.13, U621.19 (D7)
~RAM1: U607.22 (~CE), U617.5, U621.17 (D5)
~ROM0: U621.15 (D3)
~ROM1: U621.13 (D2)
~WE0: U605.3, U606.29 (~WE), U610.1 (DIR), U614.8
~WE1: U605.9, U607.29 (~WE), U611.1 (DIR), U617.6
~dmaa: U618.3

Notes on the sheet:
512KB RAM (Odd Bank)
512KB RAM (Even Bank)
