craigory1958/SBC6502/_arduino_pio/src/SBC6502_Mega2560-RetroSheld/RAM.h

                  // LOC   CODE         LABEL         INSTRUCTION

0x4C, 0x00, 0x02, // 0200  4C 00 02     HERE          JMP HERE

0x18,             // 0200  18                         CLC
0x90, 0xFE,       // 0201  90 FE        HERE          BCC HERE
                  
0xA9, 0xFF,       // 0200  A9 FF                      LDA #$FF
0x8D, 0x05, 0x02, // 0202  8D 05 02                   STA THERE
0xEA,             // 0205  EA           THERE         NOP
                  
