craigory1958/SBC6502/(commit log)

2025-12-06 More documentation
    [SBC6502 Bus.xlsx]
2026-02-22 Covert DevOps to Linux/Bash
    [6502 SBC.kicad_pcb, 6502 SBC.kicad_sch, CPU-Select.csv, Chip Select.xlsx, F0.csv, MMU Config Options.xlsx, MMU2 Calculator.xlsx, Memory-Select-Logic.xlsx]
